Jobah3/OSuRV_2024/Embedded/AC_Logger/Ekipa.jpg

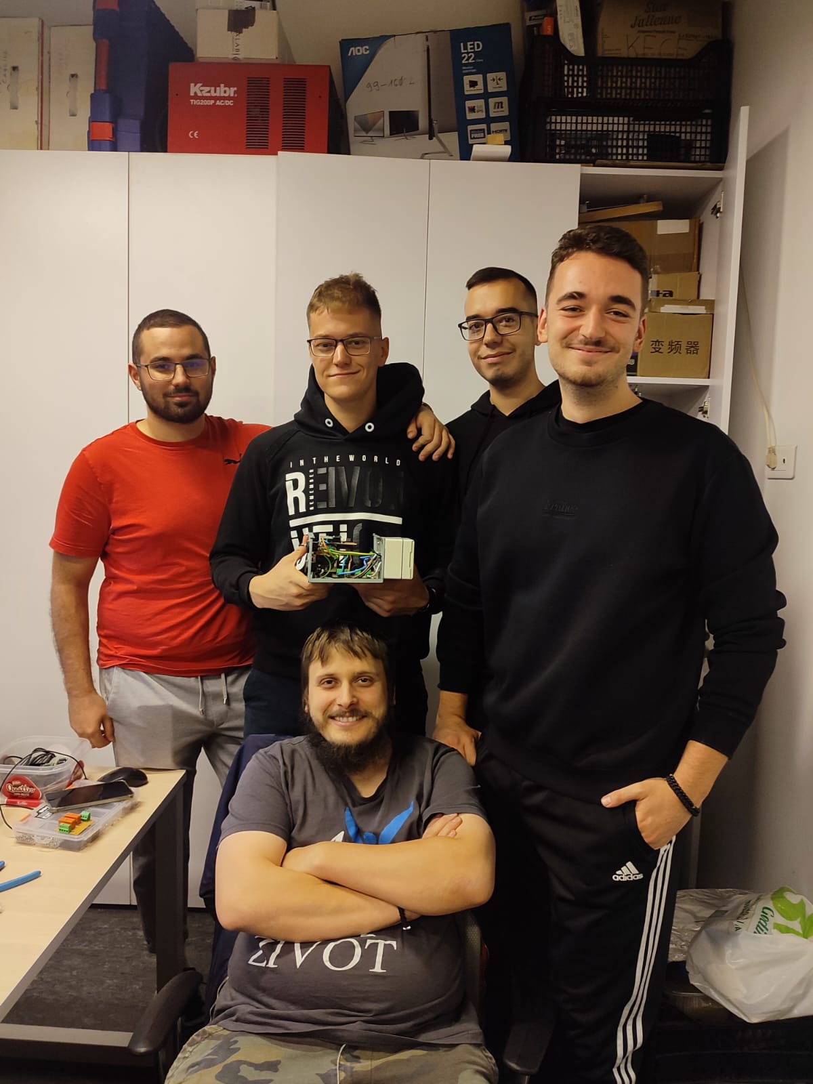
Embedded/AC_Logger/Ekipa.jpg
