Jobah3/OSuRV_2024/Embedded/AC_Logger/HW/Unnulling_Board_v2/BOM/Unulling_v2.bom.xls

Qty | Spec | Distributor | Description | šifra | RSD | Note
2 | Relay 48V DPDT >=8A | Sprint | Relej 48V 8A DPDT SCH RT424048 |  | 240
 |  | Orbit | RELE 48VDC/16A G2RL-1-E D | 3223 | 500
 |  | Orbit | RELE 48VDC/8A RT424048 | A929 | 500
5 | Zener 1.3W 47V | Sprint
 | 100R 1W
2 | 220n X2 |  |  |  |  | Apartment stock. Experiment
5 | 47u 63-100V Axial? |  |  |  |  | Experiment
