Jobah3/OSuRV_2024/Embedded/AC_Logger/HW/Unnulling_Board_v2/Unnulling_Board.kicad_pcb

## KiCad design Embedded/AC_Logger/HW/Unnulling_Board_v2/Unnulling_Board.kicad_pcb (2025-10-07)

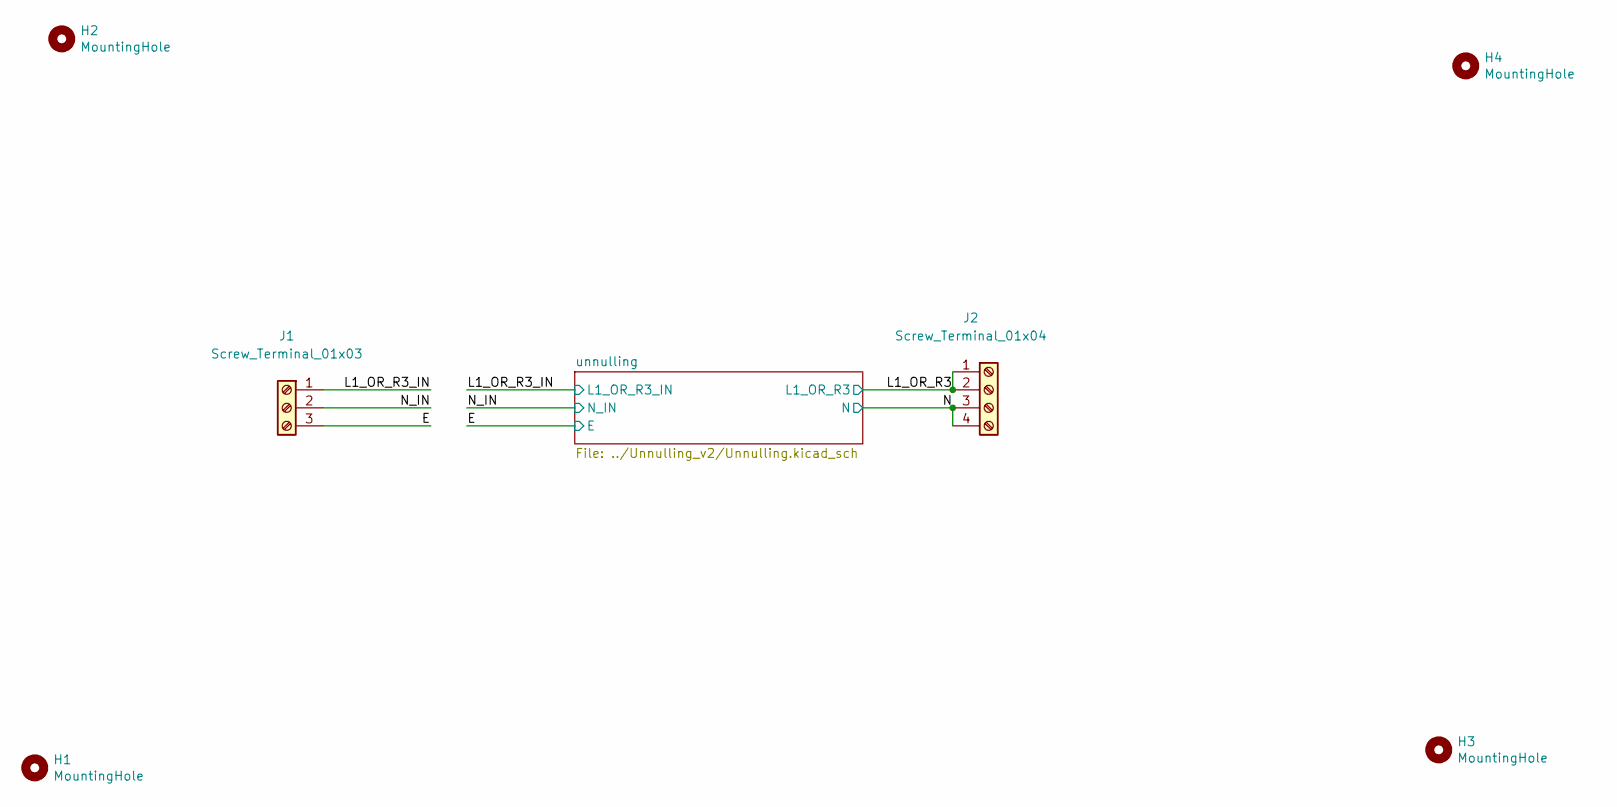
[picture p2: schematic Unnulling_Board.kicad_sch]

Parts:
H1, H2, H3, H4: MountingHole; MountingHole_3.2mm_M3_ISO7380_Pad
J1: Screw_Terminal_01x03; TerminalBlock_bornier-3_P5.08mm
J2: Screw_Terminal_01x04; TerminalBlock_bornier-4_P5.08mm

Connections:
/E: J1.3; also elsewhere on the board
/L1_OR_R3: J2.1, J2.2; also elsewhere on the board
/L1_OR_R3_IN: J1.1; also elsewhere on the board
/N: J2.3, J2.4; also elsewhere on the board
/N_IN: J1.2; also elsewhere on the board

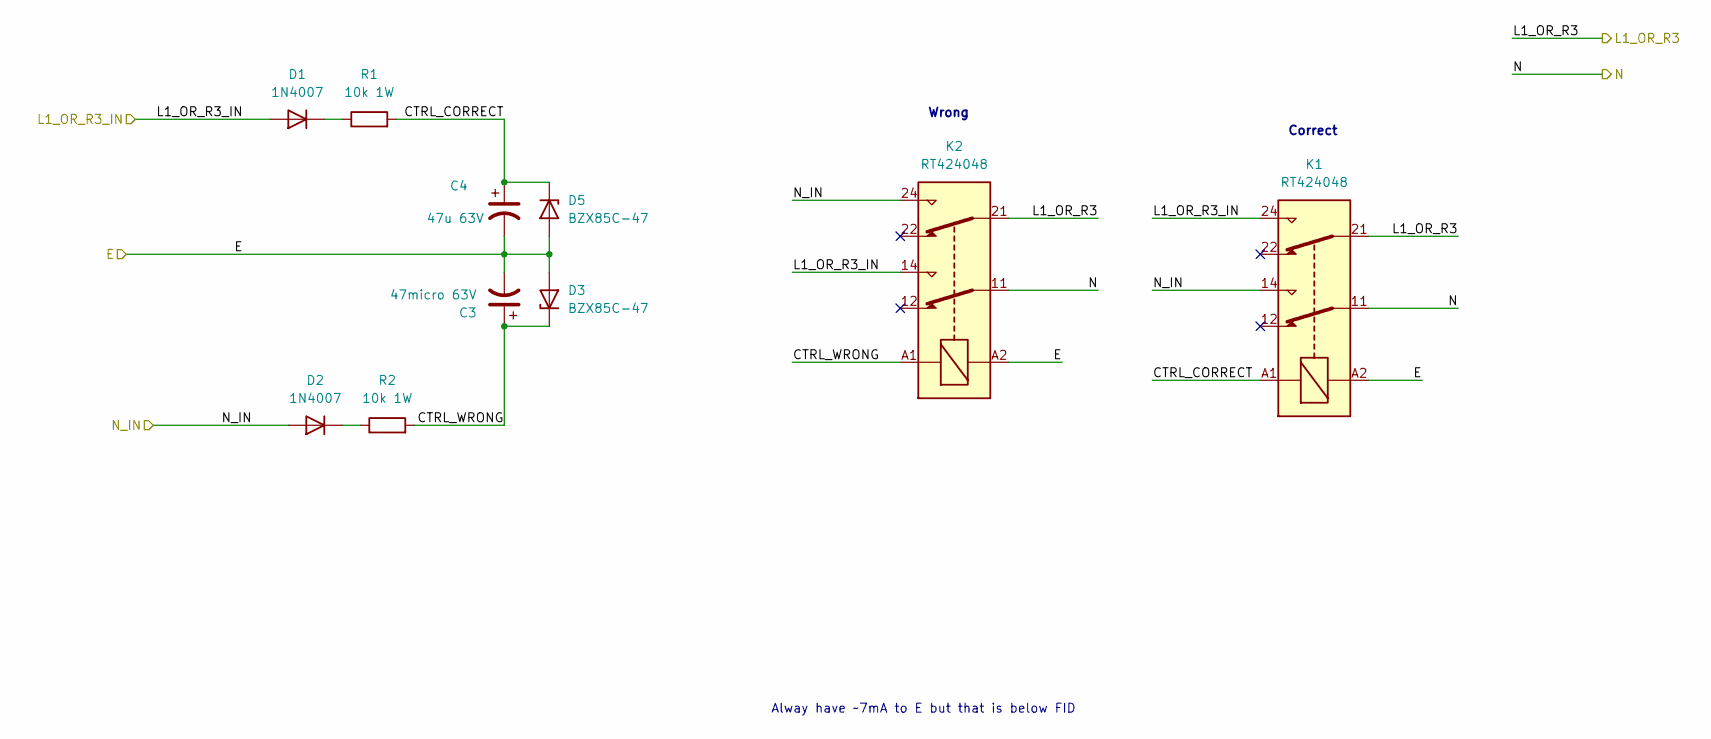
[picture p3: schematic Unnulling.kicad_sch]

Parts:
C3: 47micro 63V; CP_Radial_D6.3mm_P2.50mm
C4: 47u 63V; CP_Radial_D6.3mm_P2.50mm
D1, D2: 1N4007; D_DO-35_SOD27_Pinf_Horizontal
D3, D5: BZX85C-47; D_DO-41_SOD81_P2.54mm_Vertical_KathodeUp
K1, K2: RT424048; Relay_DPDT_Schrack-RT2-FormC_RM5mm
R1, R2: 10k 1W; R_Axial_DIN0309_L9.0mm_D3.2mm_P12.70mm_Horizontal

Connections:
/E: C3.2, C4.2, D3.2 (A), D5.2 (A), K1.A2, K2.A2; also elsewhere on the board
/L1_OR_R3: K1.21, K2.21; also elsewhere on the board
/L1_OR_R3_IN: D1.2 (A), K1.24, K2.14; also elsewhere on the board
/N: K1.11, K2.11; also elsewhere on the board
/N_IN: D2.2 (A), K1.14, K2.24; also elsewhere on the board
/unnulling/CTRL_CORRECT: C4.1, D5.1 (K), K1.A1, R1.2
/unnulling/CTRL_WRONG: C3.1, D3.1 (K), K2.A1, R2.2
unnamed: D1.1 (K), R1.1
unnamed: D2.1 (K), R2.1

Notes on the sheet:
Alway have ~7mA to E but that is below FID
Wrong
Correct

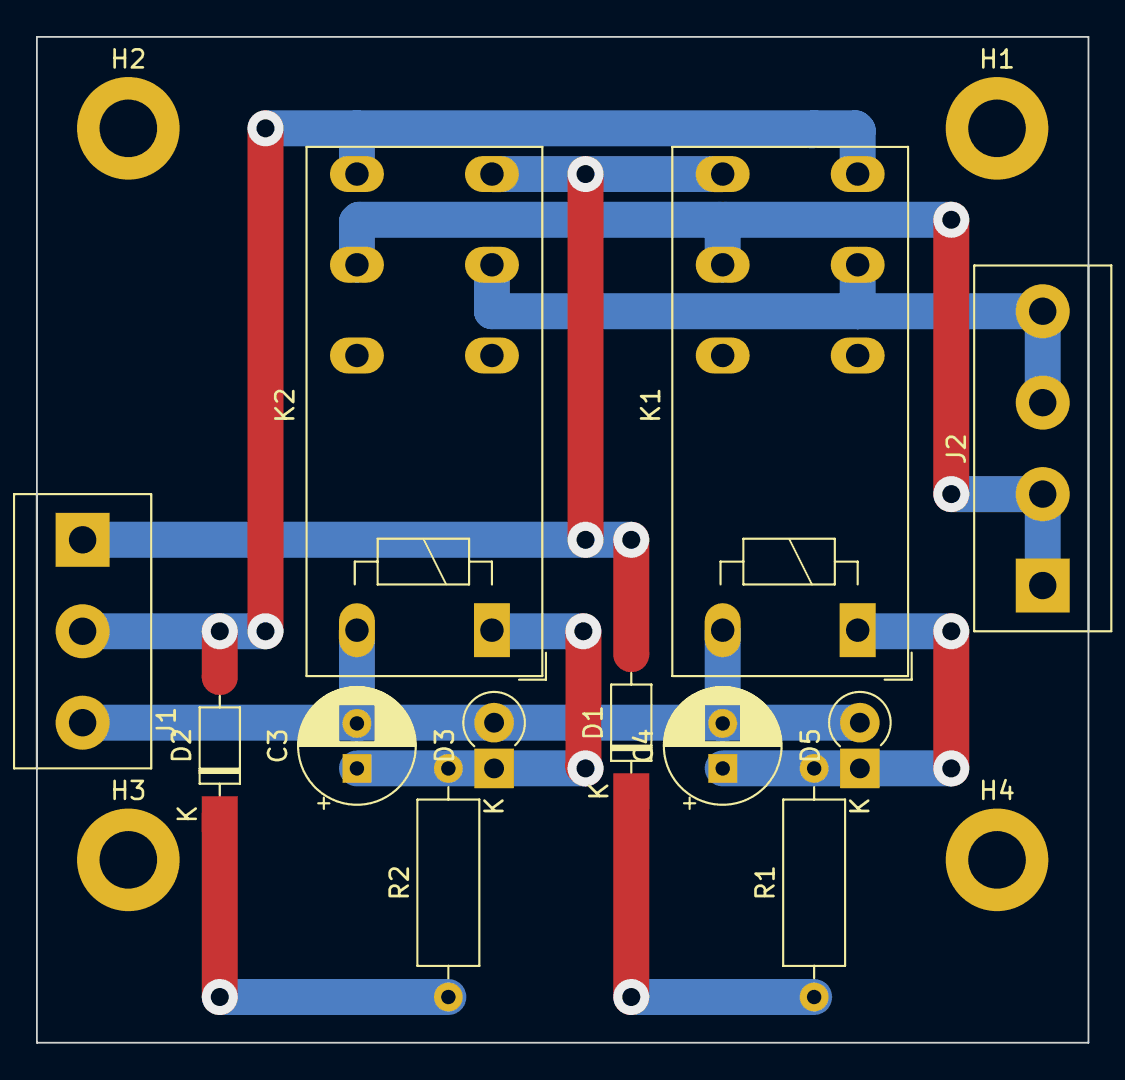
[picture p4: board Embedded/AC_Logger/HW/Unnulling_Board_v2/Unnulling_Board.kicad_pcb from above]

Board: 2 copper layers, 58.4 x 55.9 mm, 16 parts (0 on the bottom side), 9 nets.
