Jobah3/OSuRV_2024/Embedded/AC_Logger/HW/AFE_Board/AFE_Board.kicad_pcb

## KiCad design Embedded/AC_Logger/HW/AFE_Board/AFE_Board.kicad_pcb (2025-08-27)

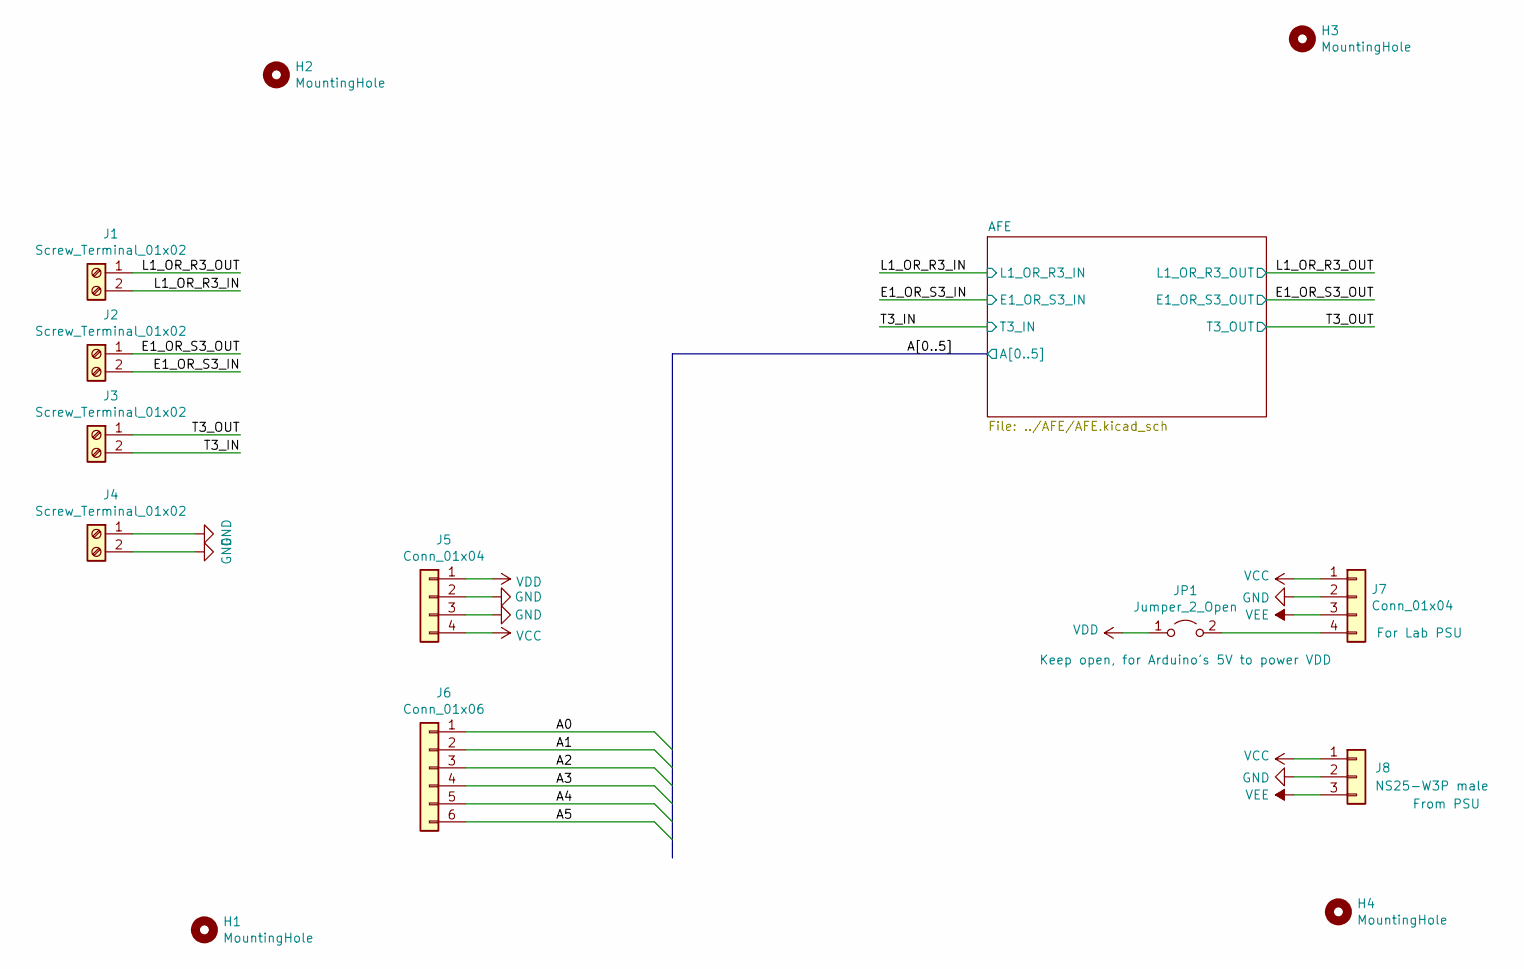
[picture p5: schematic AFE_Board.kicad_sch]

Parts:
H1, H2, H3, H4: MountingHole; MountingHole_3.2mm_M3_ISO7380_Pad
J1, J2, J3, J4: Screw_Terminal_01x02; TerminalBlock_bornier-2_P5.08mm
J5, J7: Conn_01x04; PinHeader_1x04_P2.54mm_Vertical
J6: Conn_01x06; PinHeader_1x06_P2.54mm_Vertical
J8: NS25-W3P male; Molex_KK-254_AE-6410-03A_1x03_P2.54mm_Vertical
JP1: Jumper_2_Open; PinHeader_1x02_P2.54mm_Vertical

Connections:
/A0: J6.1; also elsewhere on the board
/A1: J6.2; also elsewhere on the board
/A2: J6.3; also elsewhere on the board
/A3: J6.4; also elsewhere on the board
/A4: J6.5; also elsewhere on the board
/A5: J6.6; also elsewhere on the board
/E1_OR_S3_IN: J2.2; also elsewhere on the board
/E1_OR_S3_OUT: J2.1; also elsewhere on the board
/L1_OR_R3_IN: J1.2; also elsewhere on the board
/L1_OR_R3_OUT: J1.1; also elsewhere on the board
/T3_IN: J3.2; also elsewhere on the board
/T3_OUT: J3.1; also elsewhere on the board
GND: J4.1, J4.2, J5.2, J5.3, J7.2, J8.2; also elsewhere on the board
unnamed: J7.4, JP1.2 (B)
VCC: J5.4, J7.1, J8.1; also elsewhere on the board
VDD: J5.1, JP1.1 (A); also elsewhere on the board
VEE: J7.3, J8.3; also elsewhere on the board

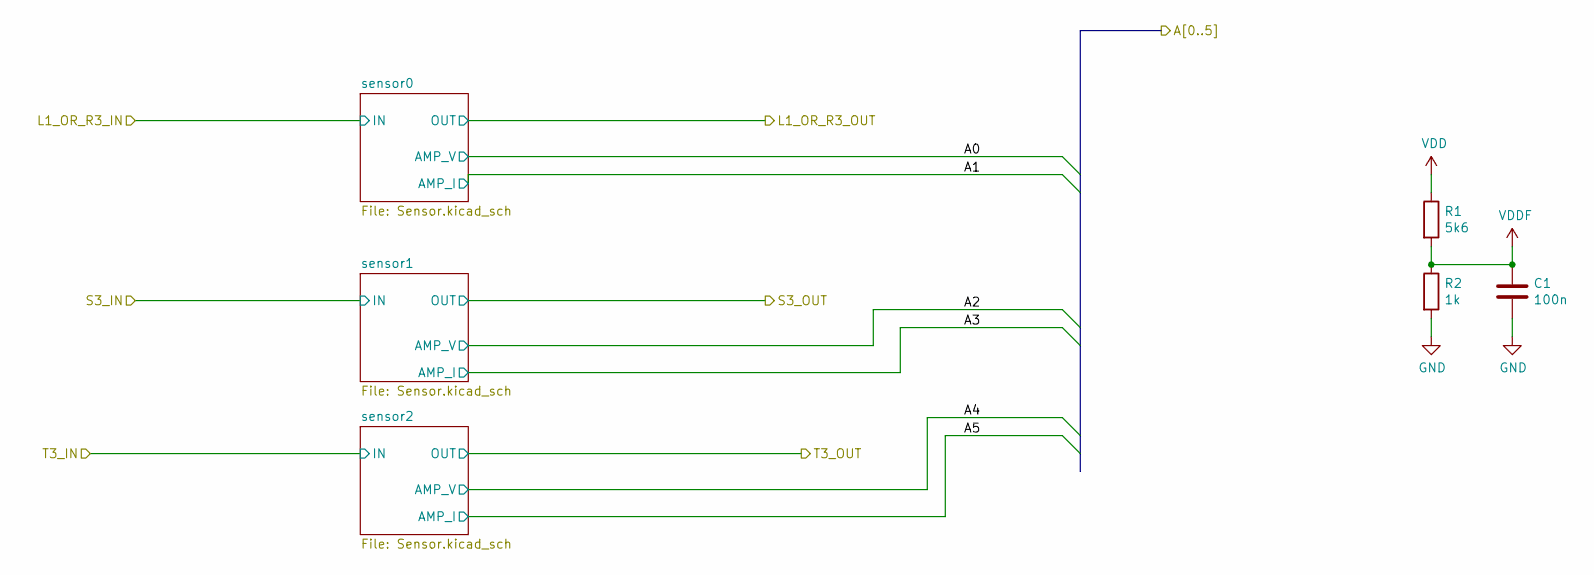
[picture p6: schematic AFE.kicad_sch]

Parts:
C1: 100n; C_Disc_D3.0mm_W1.6mm_Pinf
R1: 5k6; R_Axial_DIN0207_L6.3mm_D2.5mm_P2.54mm_Vertical
R2: 1k; R_Axial_DIN0207_L6.3mm_D2.5mm_Pinf_Horizontal

Connections:
GND: C1.2, R2.2; also elsewhere on the board
VDD: R1.1; also elsewhere on the board
VDDF: C1.1, R1.2, R2.1; also elsewhere on the board

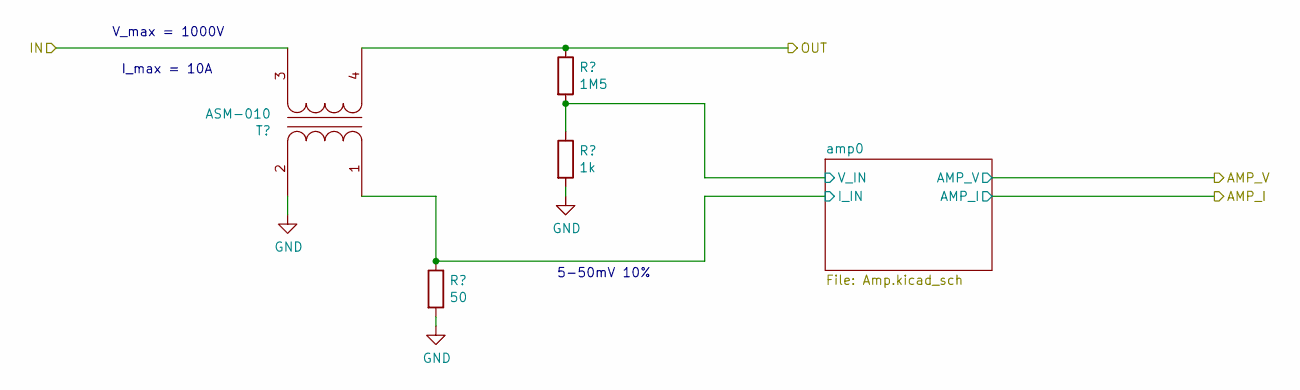
[picture p7: schematic Sensor.kicad_sch]

Parts:
R3: 50; R_Axial_DIN0207_L6.3mm_D2.5mm_Pinf_Horizontal
R4: 1M5; R_Axial_DIN0207_L6.3mm_D2.5mm_Pinf_Horizontal
R5: 1k; R_Axial_DIN0207_L6.3mm_D2.5mm_Pinf_Horizontal
T1: ASM-010

Connections:
/AFE/sensor0/amp0/I_IN: R3.1, T1.1 (AA); also elsewhere on the board
/AFE/sensor0/amp0/V_IN: R4.2, R5.1; also elsewhere on the board
/L1_OR_R3_IN: T1.3 (SA); also elsewhere on the board
/L1_OR_R3_OUT: R4.1, T1.4 (SB); also elsewhere on the board
GND: R3.2, R5.2, T1.2 (AB); also elsewhere on the board

Parts of its further copies:
R10, R17: 50; R_Axial_DIN0207_L6.3mm_D2.5mm_Pinf_Horizontal
R11, R18: 1M5; R_Axial_DIN0207_L6.3mm_D2.5mm_Pinf_Horizontal
R12, R19: 1k; R_Axial_DIN0207_L6.3mm_D2.5mm_Pinf_Horizontal
T2, T3: ASM-010

Connections of its further copies:
/AFE/sensor1/amp0/I_IN: R10.1, T2.1 (AA); also elsewhere on the board
/AFE/sensor1/amp0/V_IN: R11.2, R12.1; also elsewhere on the board
/AFE/sensor2/amp0/I_IN: R17.1, T3.1 (AA); also elsewhere on the board
/AFE/sensor2/amp0/V_IN: R18.2, R19.1; also elsewhere on the board
/E1_OR_S3_IN: T2.3 (SA); also elsewhere on the board
/E1_OR_S3_OUT: R11.1, T2.4 (SB); also elsewhere on the board
/T3_IN: T3.3 (SA); also elsewhere on the board
/T3_OUT: R18.1, T3.4 (SB); also elsewhere on the board
GND: R10.2, R12.2, R17.2, R19.2, T2.2 (AB), T3.2 (AB); also elsewhere on the board

Notes on the sheet:
V_max = 1000V
5-50mV 10%
I_max = 10A

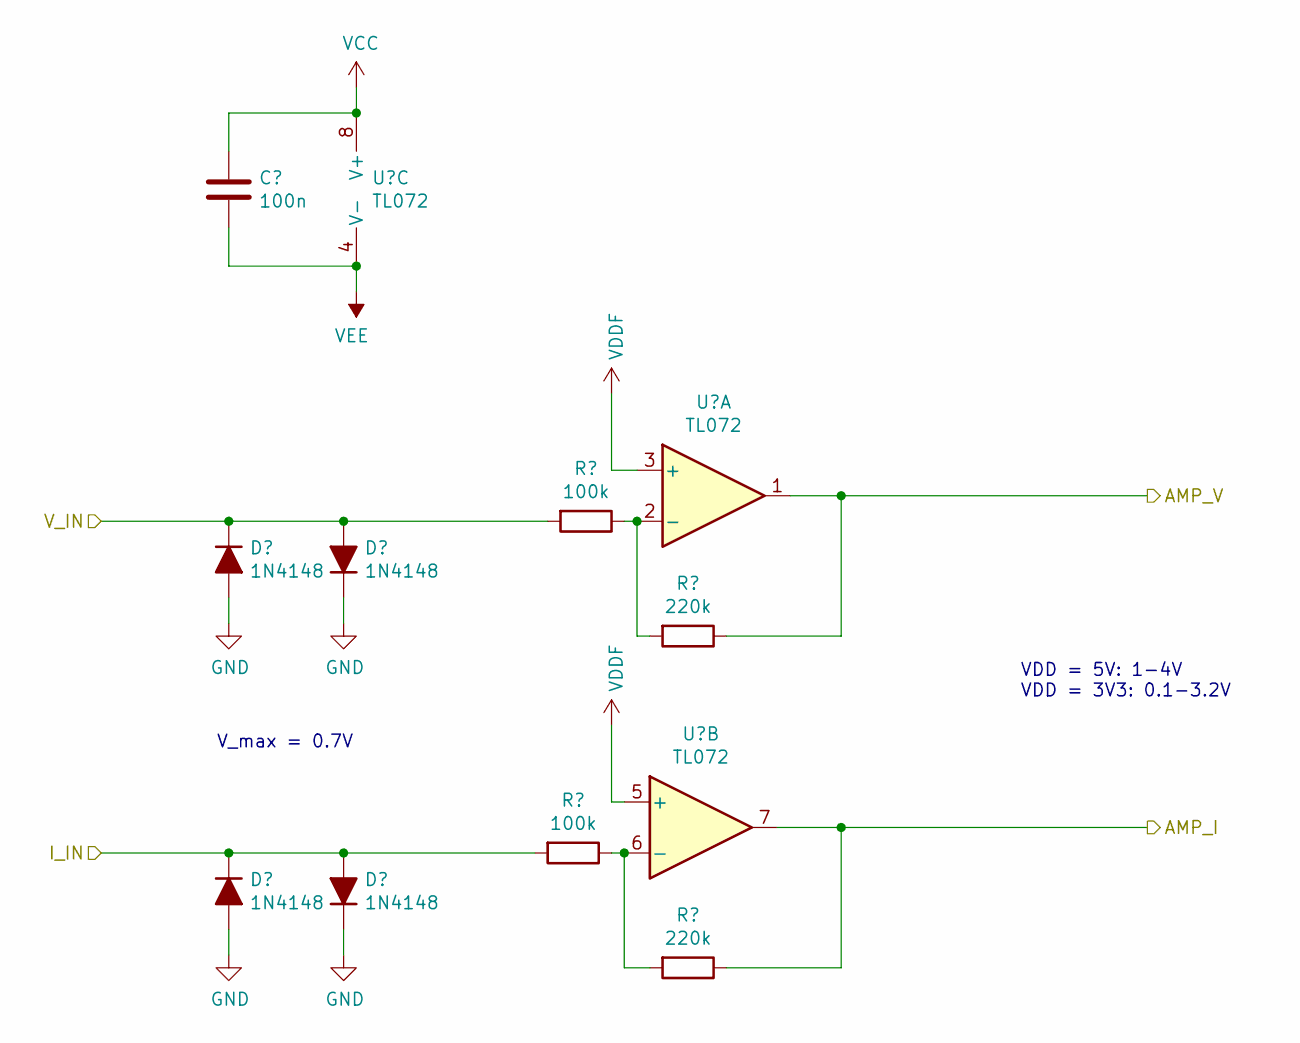
[picture p8: schematic Amp.kicad_sch]

Parts:
C2: 100n; C_Disc_D3.0mm_W1.6mm_Pinf
D1, D2, D3, D4: 1N4148; R_Axial_DIN0207_L6.3mm_D2.5mm_Pinf_Horizontal
R6, R7: 100k; R_Axial_DIN0207_L6.3mm_D2.5mm_Pinf_Horizontal
R8, R9: 220k; R_Axial_DIN0207_L6.3mm_D2.5mm_P2.54mm_Vertical
U1: TL072; DIP-8_W7.62mm

Connections:
/A0: R8.1, U1.1; also elsewhere on the board
/A1: R9.1, U1.7; also elsewhere on the board
/AFE/sensor0/amp0/I_IN: D2.1 (K), D4.2 (A), R6.2; also elsewhere on the board
/AFE/sensor0/amp0/V_IN: D1.1 (K), D3.2 (A), R7.2; also elsewhere on the board
GND: D1.2 (A), D2.2 (A), D3.1 (K), D4.1 (K); also elsewhere on the board
unnamed: R6.1, R9.2, U1.6 (-)
unnamed: R7.1, R8.2, U1.2 (-)
VCC: C2.1, U1.8 (V+); also elsewhere on the board
VDDF: U1.3 (+), U1.5 (+); also elsewhere on the board
VEE: C2.2, U1.4 (V-); also elsewhere on the board

Parts of its further copies:
C3, C4: 100n; C_Disc_D3.0mm_W1.6mm_Pinf
D5, D6, D7, D8, D9, D10, D11, D12: 1N4148; R_Axial_DIN0207_L6.3mm_D2.5mm_Pinf_Horizontal
R13, R14, R20, R21: 100k; R_Axial_DIN0207_L6.3mm_D2.5mm_Pinf_Horizontal
R15, R16, R22, R23: 220k; R_Axial_DIN0207_L6.3mm_D2.5mm_P2.54mm_Vertical
U2, U3: TL072; DIP-8_W7.62mm

Connections of its further copies:
/A2: R15.1, U2.1; also elsewhere on the board
/A3: R16.1, U2.7; also elsewhere on the board
/A4: R22.1, U3.1; also elsewhere on the board
/A5: R23.1, U3.7; also elsewhere on the board
/AFE/sensor1/amp0/I_IN: D6.1 (K), D8.2 (A), R13.2; also elsewhere on the board
/AFE/sensor1/amp0/V_IN: D5.1 (K), D7.2 (A), R14.2; also elsewhere on the board
/AFE/sensor2/amp0/I_IN: D10.1 (K), D12.2 (A), R20.2; also elsewhere on the board
/AFE/sensor2/amp0/V_IN: D9.1 (K), D11.2 (A), R21.2; also elsewhere on the board
GND: D5.2 (A), D6.2 (A), D7.1 (K), D8.1 (K), D9.2 (A), D10.2 (A), D11.1 (K), D12.1 (K); also elsewhere on the board
unnamed: R13.1, R16.2, U2.6 (-)
unnamed: R14.1, R15.2, U2.2 (-)
unnamed: R20.1, R23.2, U3.6 (-)
unnamed: R21.1, R22.2, U3.2 (-)
VCC: C3.1, C4.1, U2.8 (V+), U3.8 (V+); also elsewhere on the board
VDDF: U2.3 (+), U2.5 (+), U3.3 (+), U3.5 (+); also elsewhere on the board
VEE: C3.2, C4.2, U2.4 (V-), U3.4 (V-); also elsewhere on the board

Notes on the sheet:
V_max = 0.7V
VDD = 5V: 1-4V VDD = 3V3: 0.1-3.2V

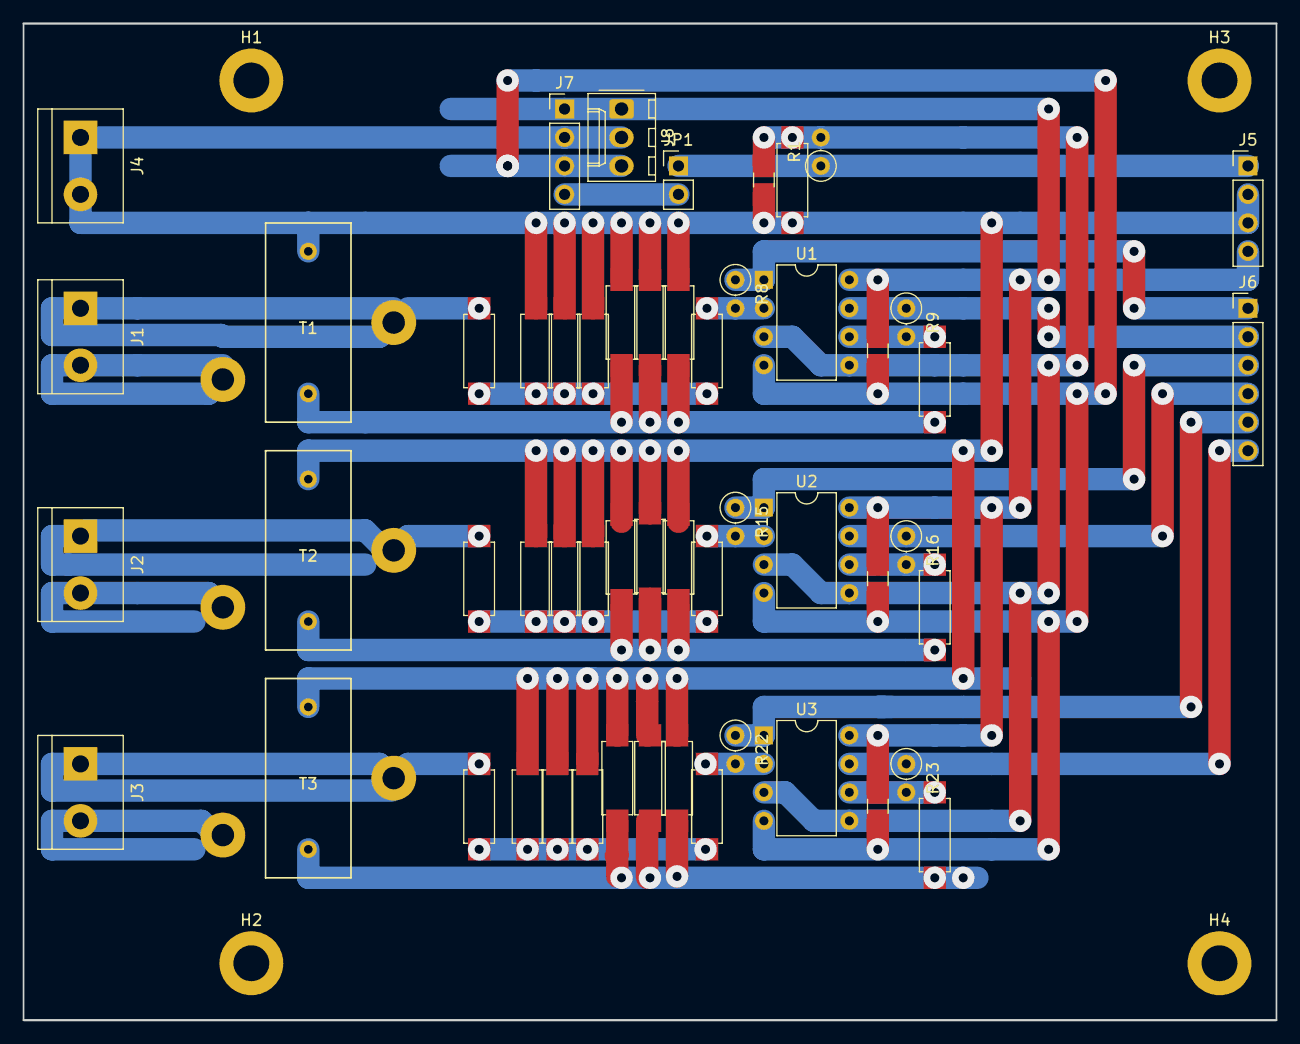
[picture p9: board AFE_Board.kicad_pcb from above]

Board: 2 copper layers, 111.8 x 88.9 mm, 58 parts (0 on the bottom side), 30 nets.
