Jobah3/OSuRV_2024/Embedded/AC_Logger/HW/PSU_Board/PSU_Board.kicad_pcb

## KiCad design Embedded/AC_Logger/HW/PSU_Board/PSU_Board.kicad_pcb (2025-08-27)

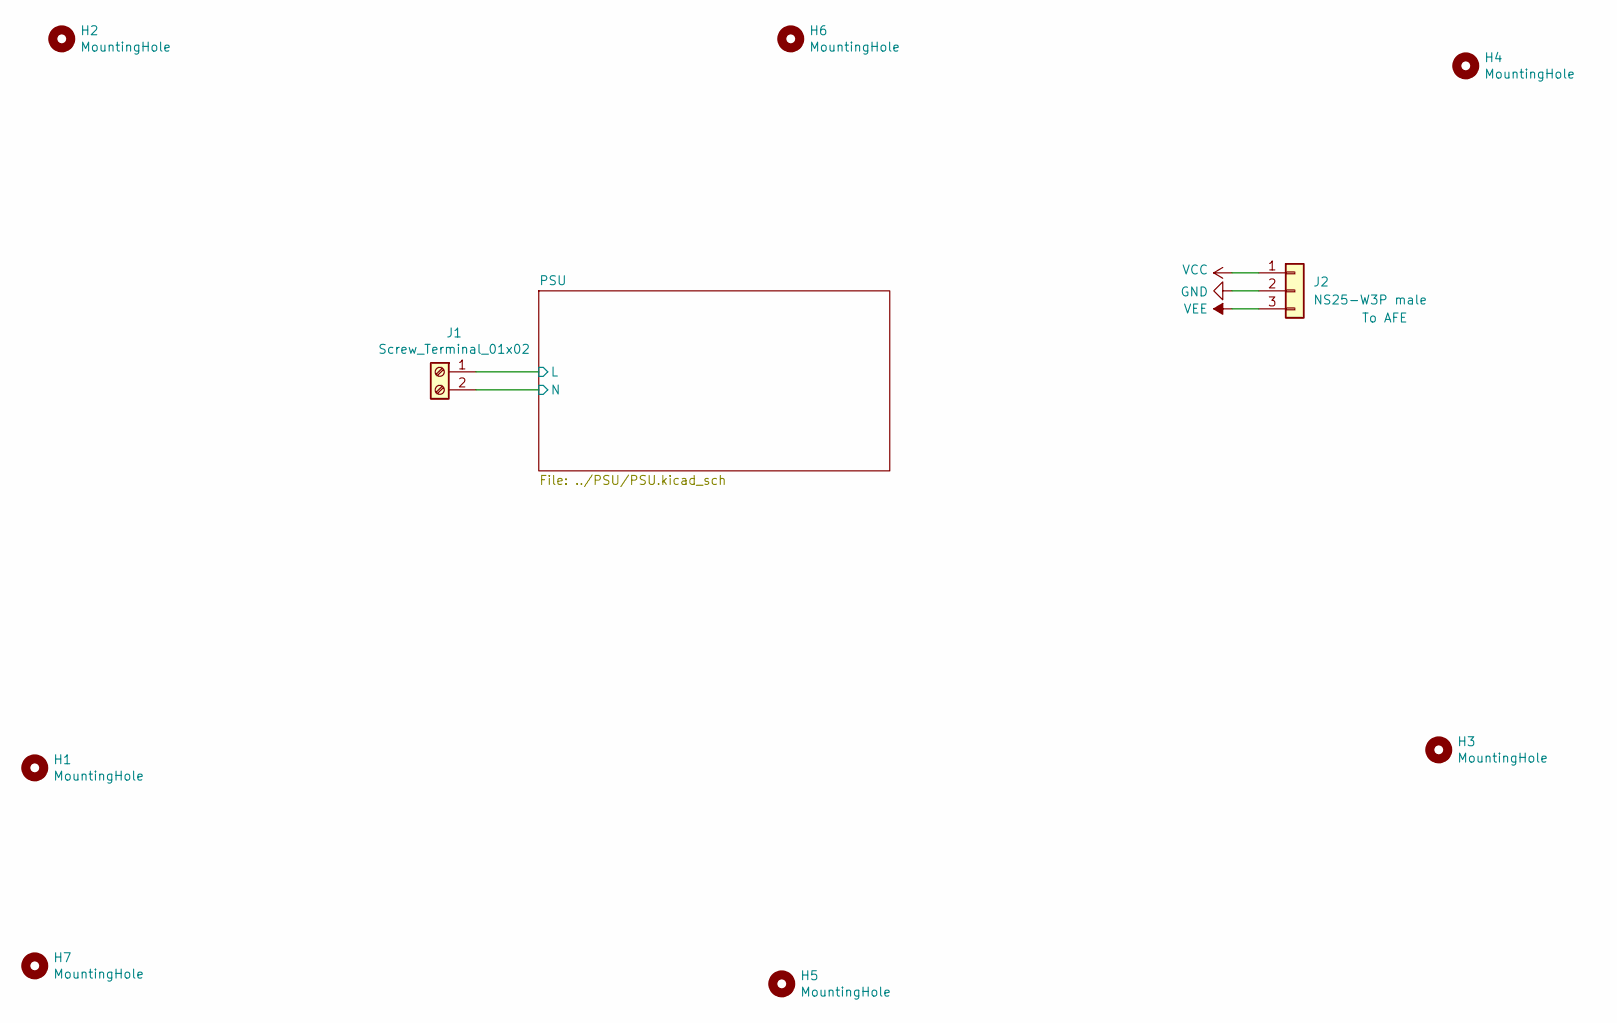
[picture p10: schematic PSU_Board.kicad_sch]

Parts:
H1, H2, H3, H4, H5, H6, H7: MountingHole; MountingHole_3.2mm_M3_ISO7380_Pad
J1: Screw_Terminal_01x02; TerminalBlock_bornier-2_P5.08mm
J2: NS25-W3P male; Molex_KK-254_AE-6410-03A_1x03_P2.54mm_Vertical

Connections:
/PSU/L: J1.1; also elsewhere on the board
/PSU/N: J1.2; also elsewhere on the board
GND: J2.2; also elsewhere on the board
VCC: J2.1; also elsewhere on the board
VEE: J2.3; also elsewhere on the board

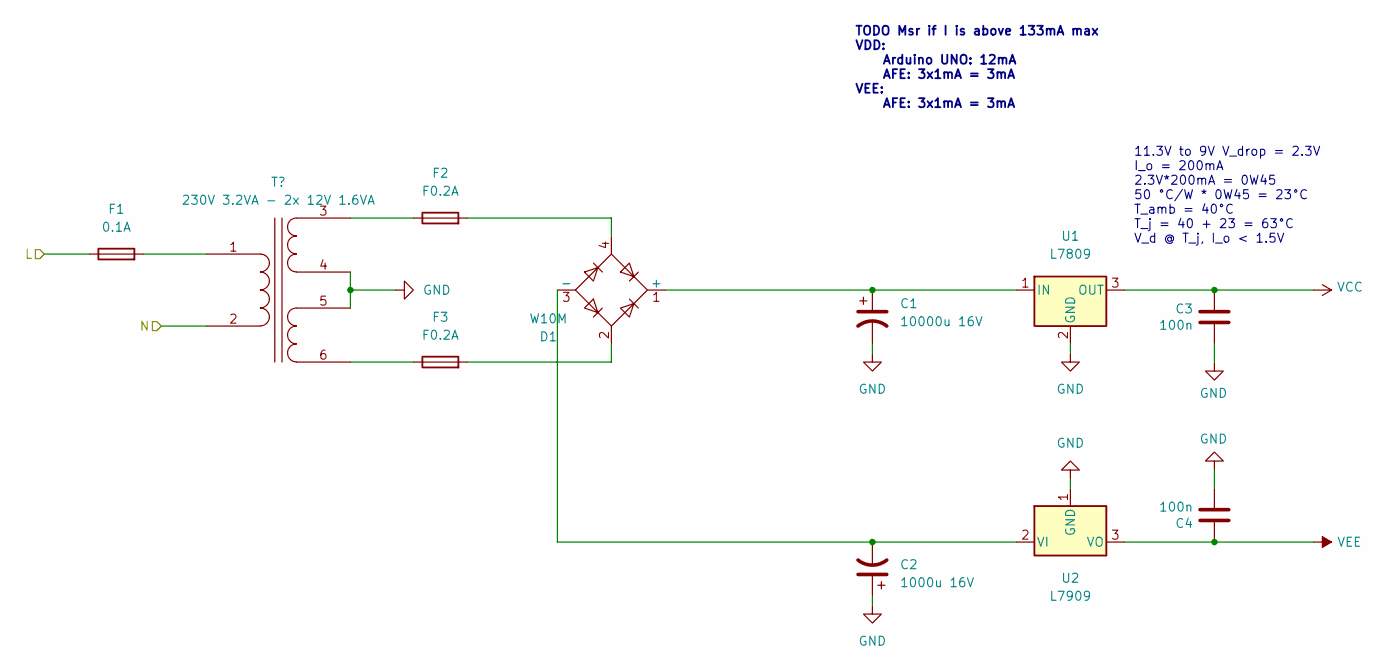
[picture p11: schematic PSU.kicad_sch]

Parts:
C1: 10000u 16V; CP_Radial_D16.0mm_P7.50mm
C2: 1000u 16V; CP_Radial_D10.0mm_P5.00mm
C3, C4: 100n; C_Disc_D3.0mm_W1.6mm_P2.50mm
D1: W10M; Diode_Bridge_Round_D9.8mm
F1: 0.1A; Fuseholder_Clip-5x20mm_Littelfuse_111_Inline_P20.00x5.00mm_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
F2, F3: F0.2A; Fuseholder_Clip-5x20mm_Littelfuse_111_Inline_P20.00x5.00mm_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
T1: 230V 3.2VA - 2x 12V 1.6VA; Transformer-3VA_2xSec
U1: L7809; TO-220-3_Vertical
U2: L7909; TO-220-3_Vertical

Connections:
/PSU/L: F1.1; also elsewhere on the board
/PSU/N: T1.2 (AB); also elsewhere on the board
GND: C1.2, C2.1, C3.2, C4.2, T1.4 (SB), T1.5 (SC), U1.2 (GND), U2.1 (GND); also elsewhere on the board
unnamed: C1.1, D1.1 (+), U1.1 (IN)
unnamed: C2.2, D1.3 (-), U2.2 (VI)
unnamed: D1.2, F3.2
unnamed: D1.4, F2.2
unnamed: F1.2, T1.1 (AA)
unnamed: F2.1, T1.3 (SA)
unnamed: F3.1, T1.6 (SD)
VCC: C3.1, U1.3 (OUT); also elsewhere on the board
VEE: C4.1, U2.3 (VO); also elsewhere on the board

Notes on the sheet:
TODO Msr if I is above 133mA max VDD: Arduino UNO: 12mA AFE: 3x1mA = 3mA VEE: AFE: 3x1mA = 3mA
11.3V to 9V V_drop = 2.3V I_o = 200mA 2.3V*200mA = 0W45 50 °C/W * 0W45 = 23°C T_amb = 40°C T_j = 40 + 23 = 63°C V_d @ T_j, I_o < 1.5V

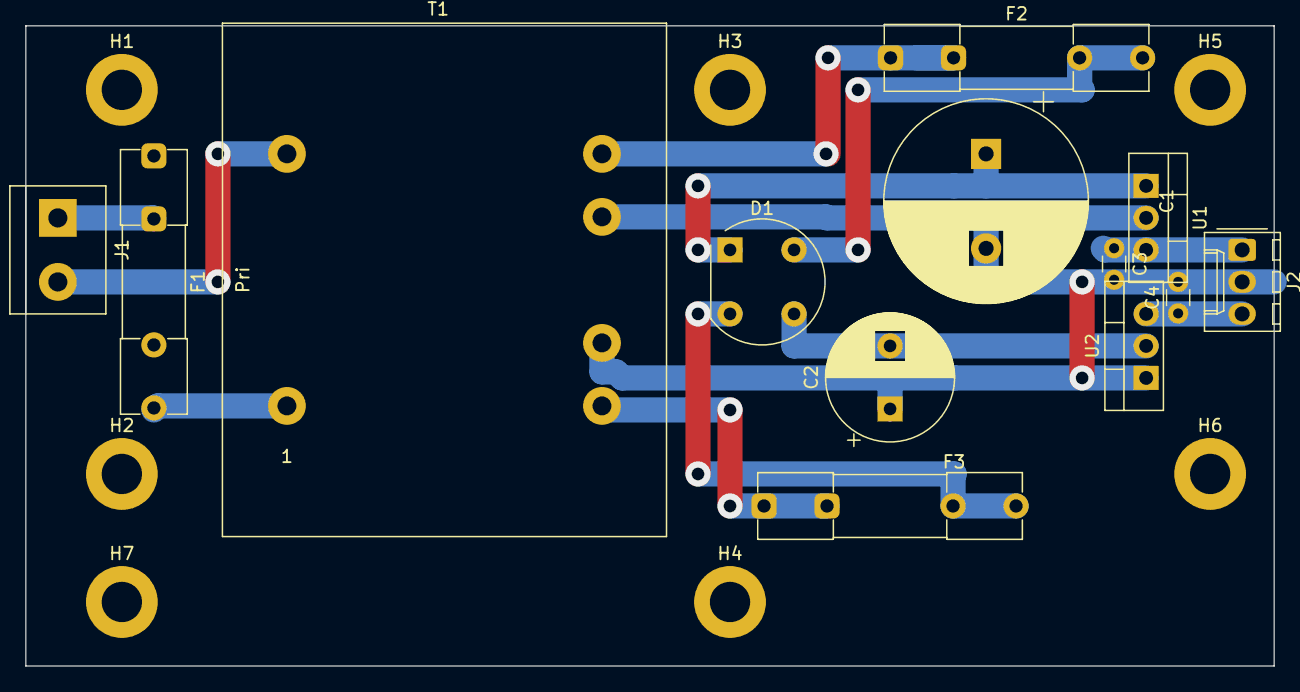
[picture p12: board PSU_Board.kicad_pcb from above]

Board: 2 copper layers, 99.1 x 50.8 mm, 20 parts (0 on the bottom side), 12 nets.
