Jobah3/OSuRV_2024/Embedded/AC_Logger/HW/Unnulling_Board/Unnulling_Board.kicad_pcb

## KiCad design Embedded/AC_Logger/HW/Unnulling_Board/Unnulling_Board.kicad_pcb (2025-07-23, an earlier design)

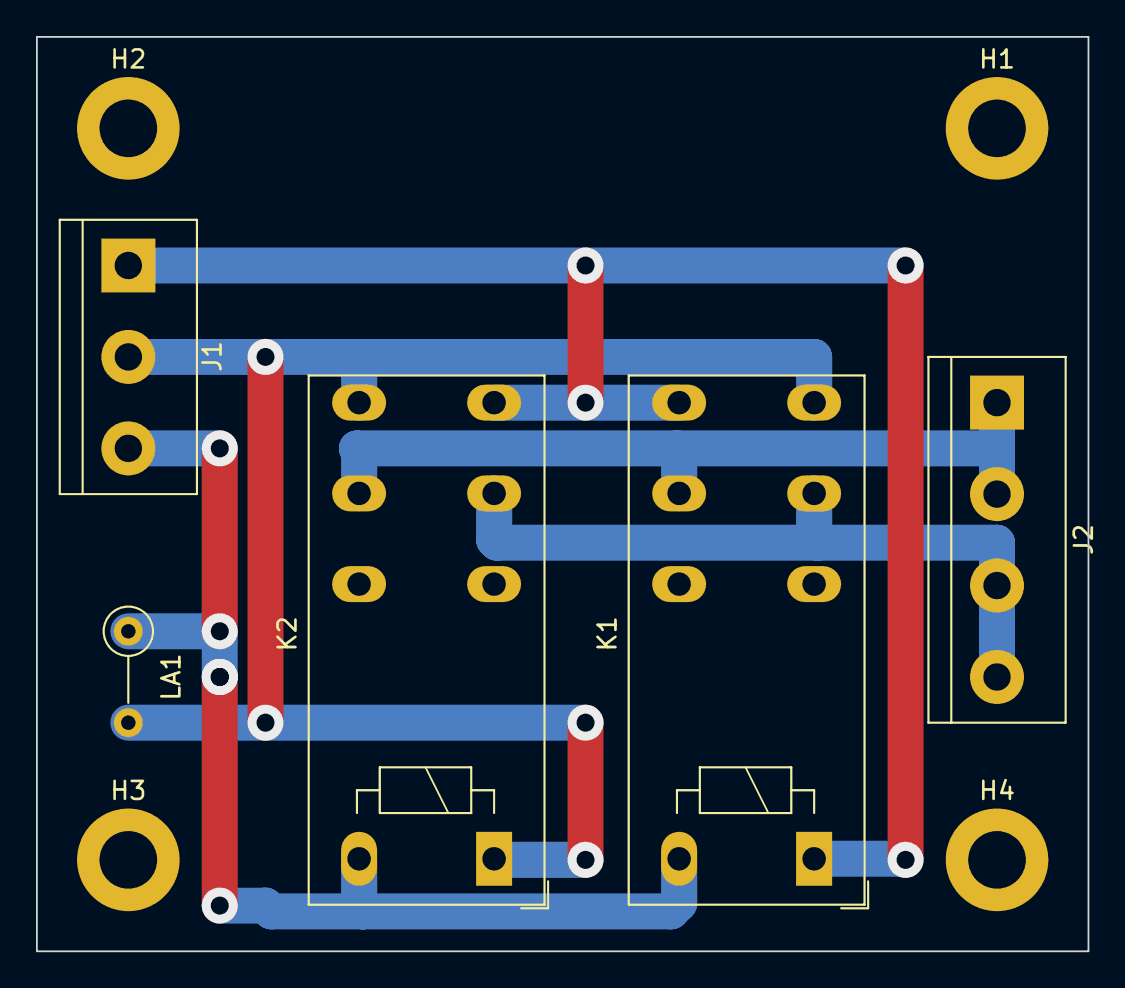
[picture p13: board Embedded/AC_Logger/HW/Unnulling_Board/Unnulling_Board.kicad_pcb from above]

Board: 2 copper layers, 58.4 x 50.8 mm, 9 parts (0 on the bottom side), 5 nets.

Parts:
H1, H2, H3, H4: MountingHole; MountingHole_3.2mm_M3_ISO7380_Pad
J1: Screw_Terminal_01x03; TerminalBlock_bornier-3_P5.08mm
J2: Screw_Terminal_01x04; TerminalBlock_bornier-4_P5.08mm
K1, K2: RT424730; Relay_DPDT_Schrack-RT2-FormC_RM5mm
LA1: Lamp; R_Axial_DIN0207_L6.3mm_D2.5mm_P5.08mm_Vertical

Connections:
/E: J1.3, K1.A2, K2.A2, LA1.1 (-)
/L1_OR_R3: J2.1, J2.2, K1.21, K2.21
/L1_OR_R3_IN: J1.1, K1.24, K1.A1, K2.14
/N: J2.3, J2.4, K1.11, K2.11
/N_IN: J1.2, K1.14, K2.24, K2.A1, LA1.2 (+)
