Jobah3/OSuRV_2024/(commit log)

2025-07-23 PCB changed to make sandwitch.
    [PSU.kicad_sch, PSU_Board.kicad_pcb, PSU_Board.kicad_sch, Unnulling_Board.kicad_pcb]
2025-07-24 Not needed.
    [chassis_enum.tsv]
2025-07-24 Also not needed.
    [Pins.tsv]
2025-08-29 BOM for new board.
    [Unulling_v2.bom.xls]
2025-09-30 New PCB.
    [Unnulling.kicad_sch, Unnulling_Board.kicad_pcb, Unnulling_Board.kicad_sch]
2025-09-30 Final v2
    [Unnulling.kicad_sch, Unnulling_Board.kicad_pcb, Unnulling_Board.kicad_sch]
